anish-narain/Moon-Rover/MagneticSensor/PXL_20220523_095841028.jpg

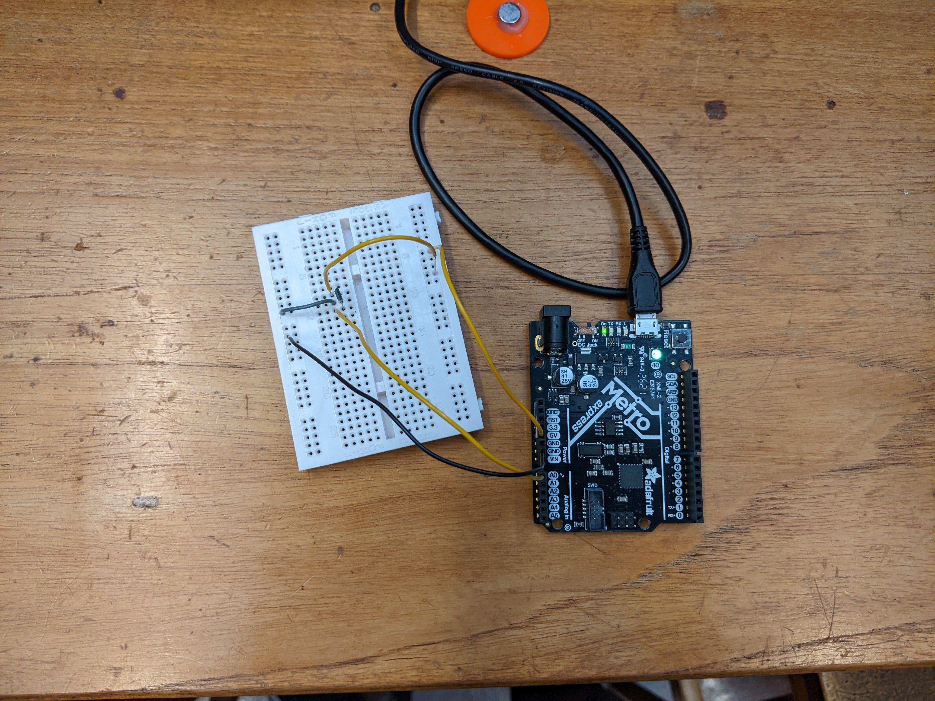
MagneticSensor/PXL_20220523_095841028.jpg
