anish-narain/Moon-Rover/InfraredSensor/PXL_20220530_113433970.jpg

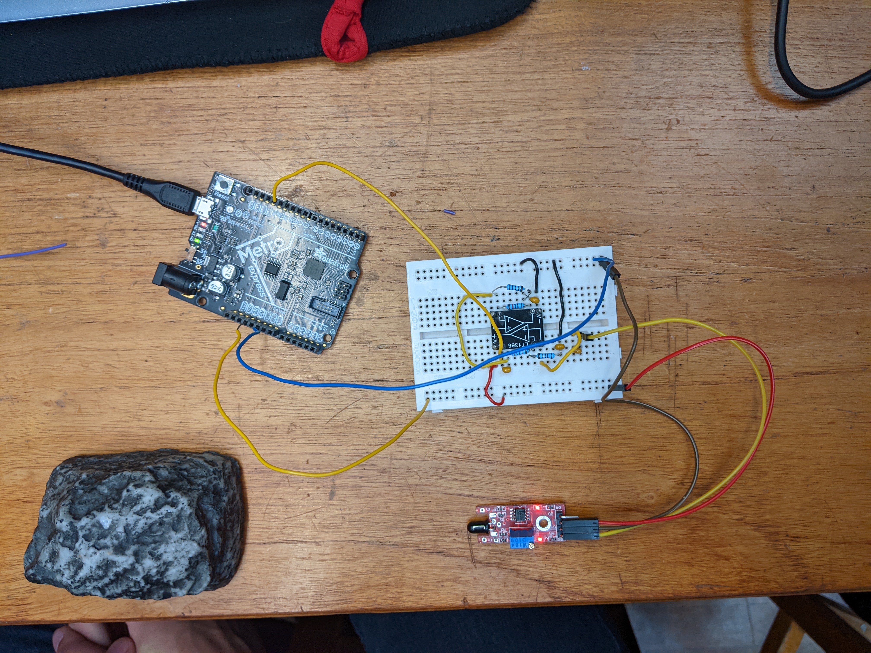
InfraredSensor/PXL_20220530_113433970.jpg
