anish-narain/Moon-Rover/InfraredSensor/PXL_20220530_113431750.jpg

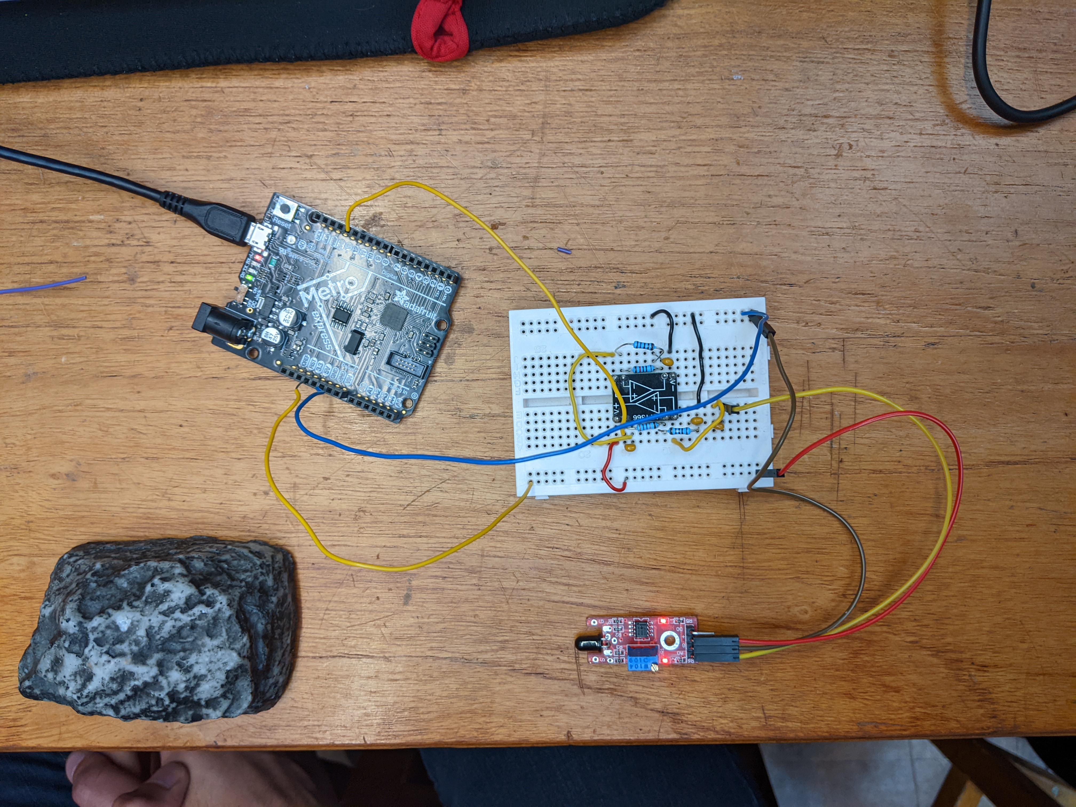
InfraredSensor/PXL_20220530_113431750.jpg
