anish-narain/Moon-Rover/UltrasonicSensor/DetectedImage.jpg

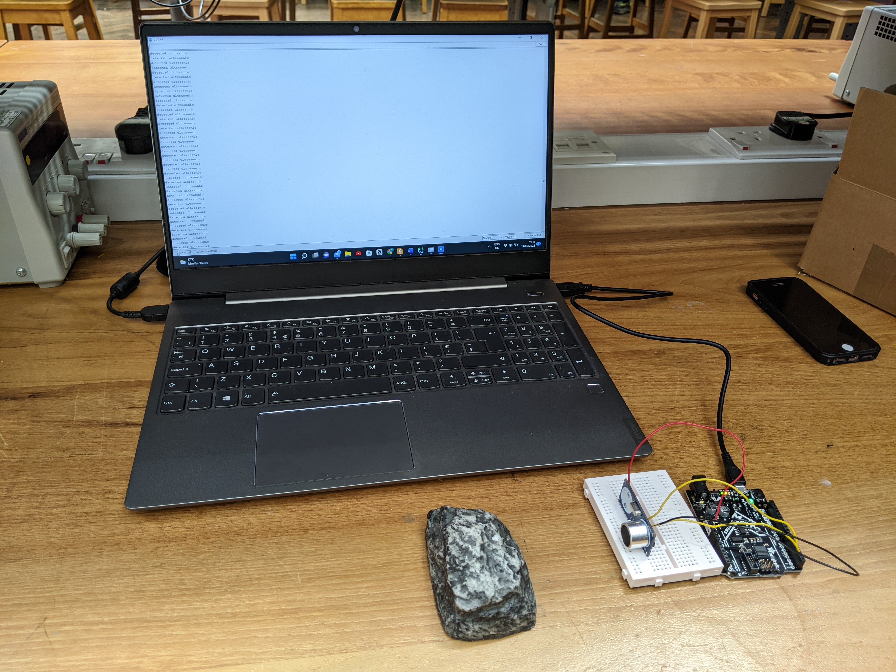
UltrasonicSensor/DetectedImage.jpg
