anish-narain/Moon-Rover/UltrasonicSensor/NotDetectedImage.jpg

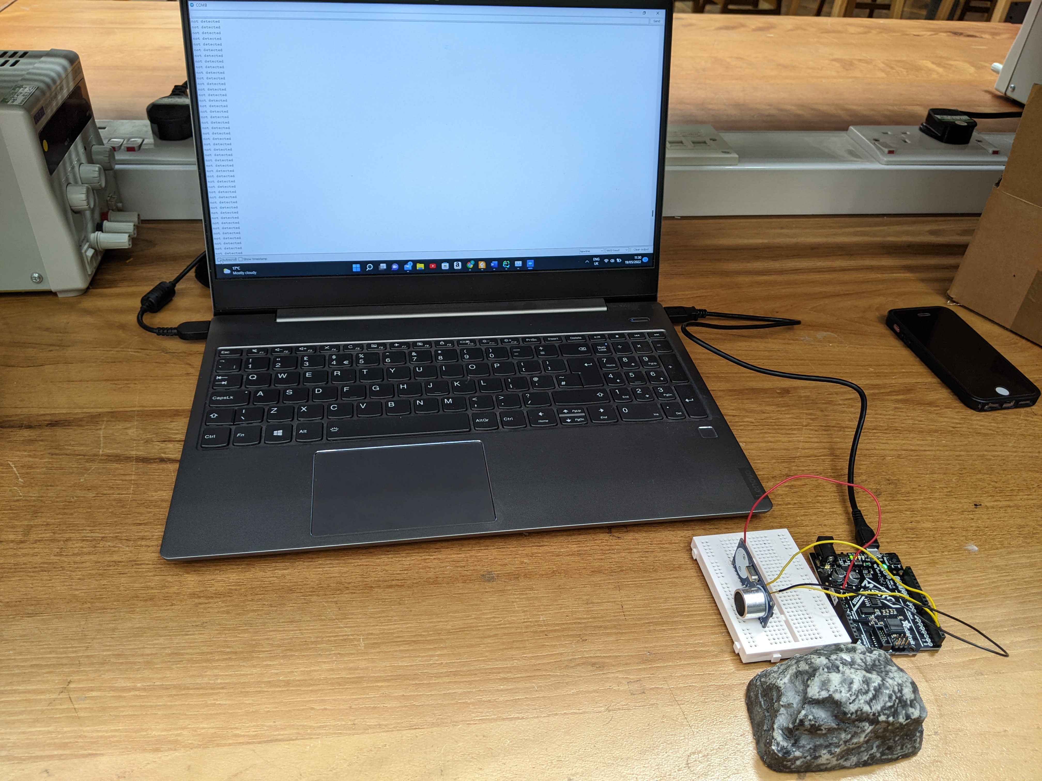
UltrasonicSensor/NotDetectedImage.jpg
