anish-narain/Moon-Rover/Chassis/chassis.dxf

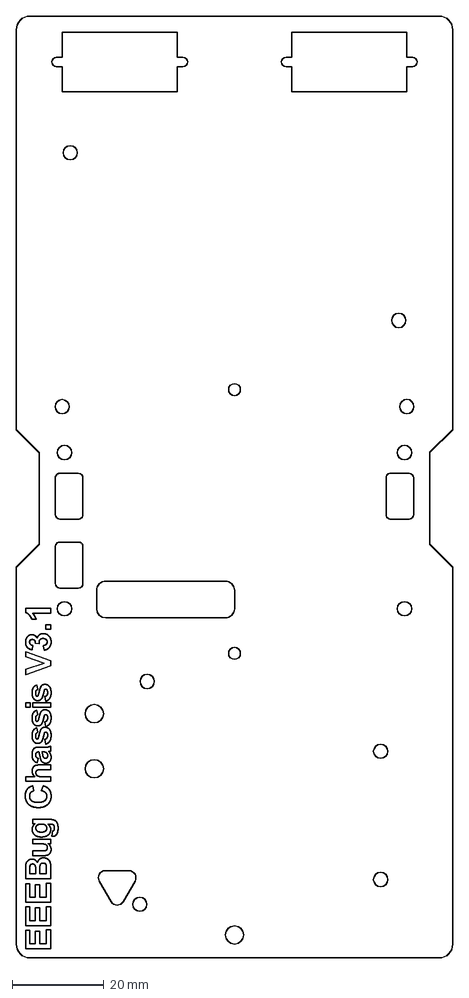
[picture p87: CAD file, 2023-07-22]
Chassis/chassis.dxf
95.0 x 205.0 mm
